Kawthaar-tj/ESP32-Camion-Liquid-Monitoring/docs/architecture/README.md

# System Architecture 
this folder contains high-level system architecture diagrams (hardware + data flow).
