Kawthaar-tj/ESP32-Camion-Liquid-Monitoring/docs/integration/README.md

## Engineering Constraints

- Tank total height: 34.1 cm
- Effective sensor stroke: 27 cm
- Non-measured volume: ~0.55 L
- Compensation applied in firmware
