Kawthaar-tj/ESP32-Camion-Liquid-Monitoring/docs/prototype/README.md

## Physical Prototype

<p align="center">
  
</p>

This picture shows the real hardware prototype including:
- ESP32 development board
- Dual resistive float level sensors
- Voltage divider circuits
- LCD 1602 I2C display
- 12V power supply with regulation
