Kawthaar-tj/ESP32-Camion-Liquid-Monitoring/docs/integration/sensor_mount_detail.png

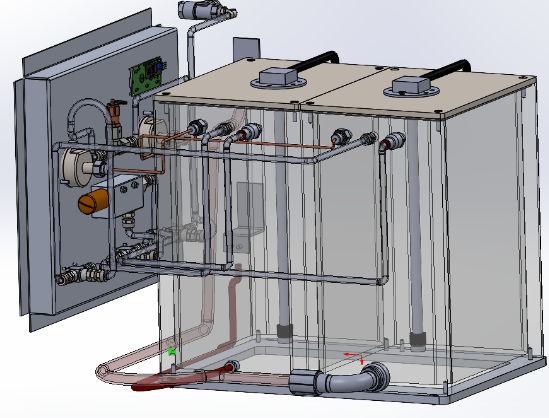
docs/integration/sensor_mount_detail.png
