Kawthaar-tj/ESP32-Camion-Liquid-Monitoring/docs/integration/system_integration_overview.png

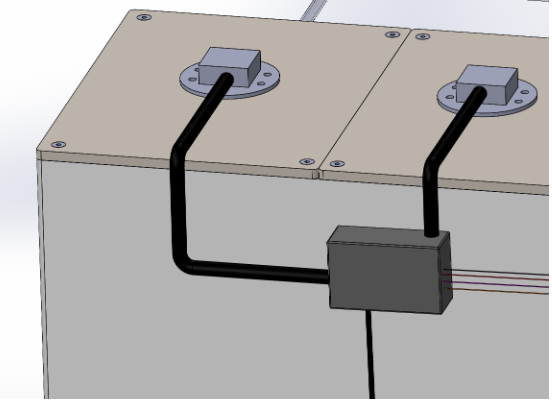
docs/integration/system_integration_overview.png
