Kawthaar-tj/ESP32-Camion-Liquid-Monitoring/docs/nodered/Dashboard.png

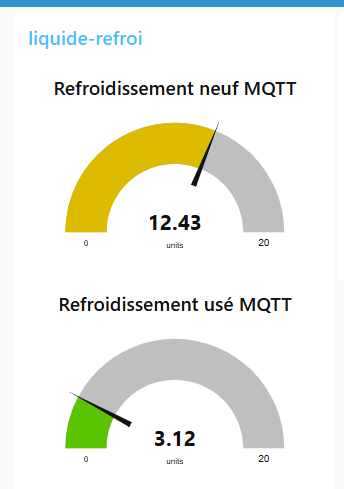
docs/nodered/Dashboard.png
