Kawthaar-tj/ESP32-Camion-Liquid-Monitoring/docs/prototype/prototype.png

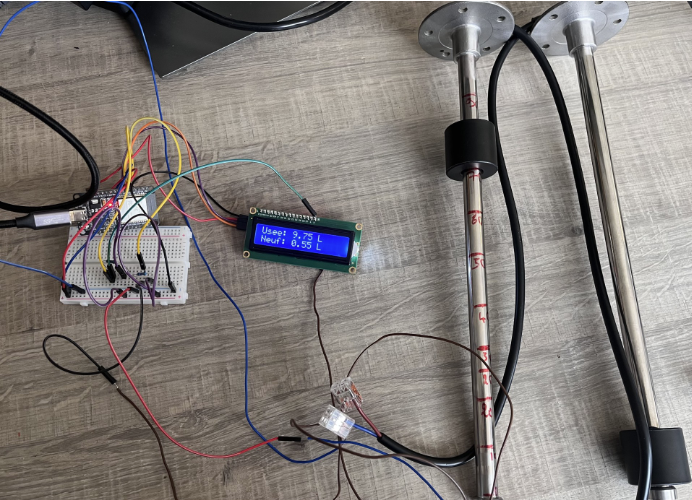
docs/prototype/prototype.png
