Kawthaar-tj/ESP32-Camion-Liquid-Monitoring/mqtt/liquide_node .png

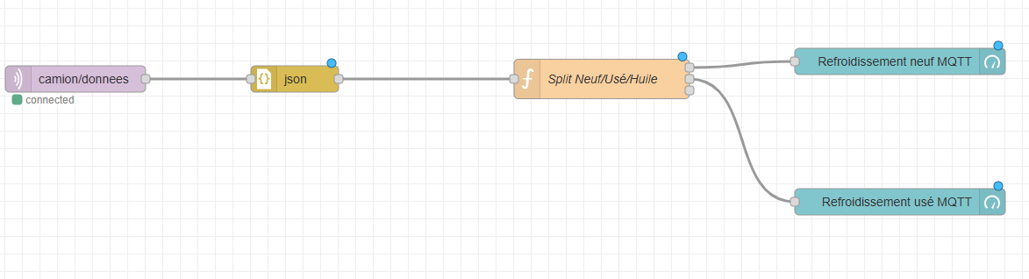
mqtt/liquide_node .png
