Kawthaar-tj/ESP32-Camion-Liquid-Monitoring/docs/calibration/README.md

# Calibration

This folder contains the experimental calibration data used to map sensor voltage to liquid level (%).
See `calibration_table.csv`.
