Kawthaar-tj/ESP32-Camion-Liquid-Monitoring/firmware/esp32/config.example.h

#pragma once

// ---- WiFi ----
#define WIFI_SSID "CHANGE_ME"
#define WIFI_PASS "CHANGE_ME"

// ---- MQTT ----
#define MQTT_HOST "192.168.X.X"
#define MQTT_PORT 1883
#define MQTT_TOPIC "camion/donnees"
#define DEVICE_ID  "camion_X"

// Optional: if your broker requires login
#define MQTT_USER ""
#define MQTT_PASS ""
