Kawthaar-tj/ESP32-Camion-Liquid-Monitoring/(commit log)

2026-02-19 Add initial ESP32 firmware
    First version of liquid tank monitoring system with MQTT transmission and LCD display.
2026-03-02 Update and rename camion_liquide.ino to firmware/esp32/camion_liquide.ino
2026-03-02 Rename schéma 2res.png to wiring_diagram.png
2026-03-02 Update README with calibration data details
    Added information about calibration data and reference file.
2026-03-03 Add calibration data to calibration_table.csv
    [calibration_table.csv]
2026-03-03 Document physical prototype and its components
    Added a section detailing the physical prototype and its components.
2026-03-04 Create prototype
2026-03-04 Document physical prototype and components
    Added details about the physical prototype and its components.
2026-03-12 Fix MQTT_HOST IP address format
    [config.example.h]
